cculpepper/SpexPressureSensor/SpexPressureSensor.kicad_pcb

## KiCad design SpexPressureSensor.kicad_pcb (2016-04-12)

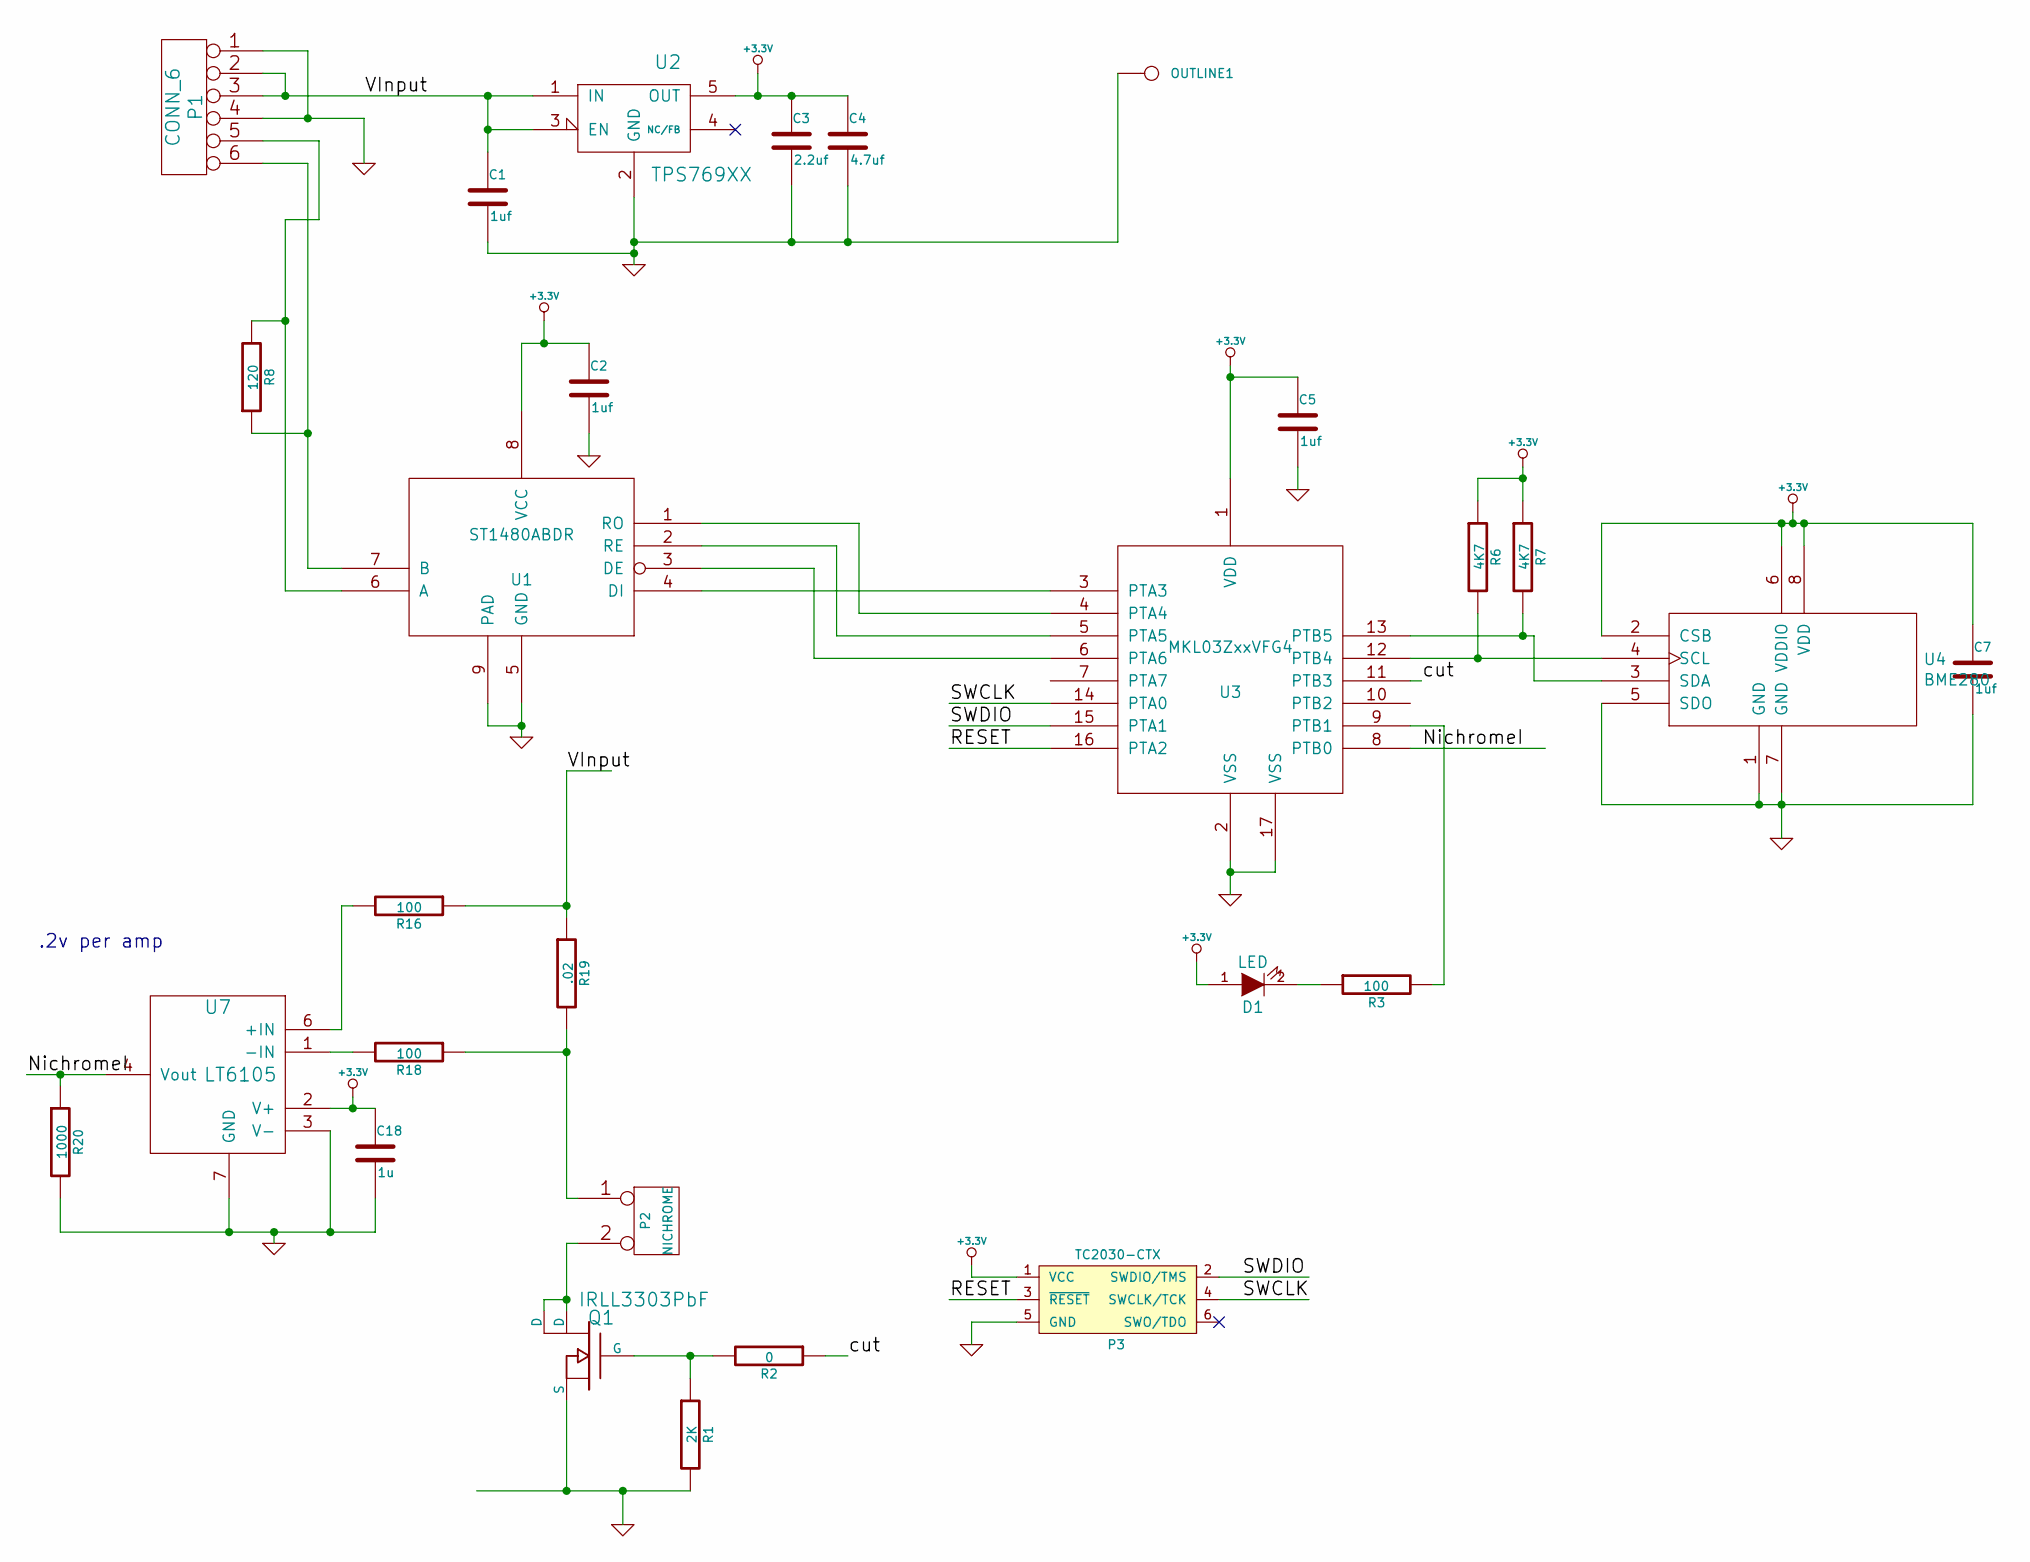
[picture p1: schematic SpexPressureSensor.sch]

Parts:
C1, C2, C5, C7: 1uf; C_0402
C3: 2.2uf; C_0603
C4: 4.7uf; C_0603
C18: 1u; C_0402
D1: LED; LED-0603
OUTLINE1: CONN_1; PLUG_OUTLINE
P1: CONN_6; Connector_Molex_PicoBlade_53047-0610
P2: NICHROME; Pin_Header_Straight_1x02
P3: TC2030-CTX; TC2030-NL_SMALL
Q1: IRLL3303PbF; SOT-223
R1: 2K; R_0402
R2: 0; R_0402
R3, R16, R18: 100; R_0402
R6, R7: 4K7; R_0402
R8: 120; R_0402
R19: .02; R_0805
R20: 1000; R_0402
U1: ST1480ABDR; DFN-8-1EP_3x3mm_Pitch0.5mm; Manufacturer PN LTC2851IDD
U2: TPS769XX; SOT-23-5; Manufacturer PN NCP500SN33T1G
U3: MKL03ZxxVFG4; QFN-16-1EP_3x3mm_Pitch0.5mm
U4: BME280; LGA-8
U7: LT6105

Connections:
+3.3V: C2.1, C3.1, C4.1, C5.1, C7.1, C18.1, D1.1 (A), P3.1 (VCC), R6.1, R7.1, U1.8 (VCC), U2.5 (OUT), U3.1 (VDD), U4.2 (CSB), U4.6 (VDDIO), U4.8 (VDD), U7.2 (V+)
/NichromeI: R20.1, U3.8 (PTB0), U7.4 (Vout)
/RESET: P3.3 (~RESET~), U3.16 (PTA2)
/SWCLK: P3.4 (SWCLK/TCK), U3.14 (PTA0)
/SWDIO: P3.2 (SWDIO/TMS), U3.15 (PTA1)
/VInput: C1.1, P1.2, P1.3, R16.1, R19.1, U2.1 (IN), U2.3 (EN)
/cut: R2.1, U3.11 (PTB3)
GND: C1.2, C2.2, C3.2, C4.2, C5.2, C7.2, C18.2, OUTLINE1.1, P1.1, P1.4, P3.5 (GND), Q1.3 (S), R1.2, R20.2, U1.5 (GND), U1.9 (PAD), U2.2 (GND), U3.2 (VSS), U3.17 (VSS), U4.1 (GND), U4.5 (SDO), U4.7 (GND), U7.3 (V-), U7.7 (GND)
unnamed: D1.2 (K), R3.1
unnamed: P1.5, R8.2, U1.6 (A)
unnamed: P1.6, R8.1, U1.7 (B)
unnamed: P2.1, R18.1, R19.2
unnamed: P2.2 (PM), Q1.2 (D), Q1.4 (D)
unnamed: Q1.1 (G), R1.1, R2.2
unnamed: R3.2, U3.9 (PTB1)
unnamed: R6.2, U3.12 (PTB4), U4.4 (SCL)
unnamed: R7.2, U3.13 (PTB5), U4.3 (SDA)
unnamed: R16.2, U7.6 (+IN)
unnamed: R18.2, U7.1 (-IN)
unnamed: U1.1 (RO), U3.4 (PTA4)
unnamed: U1.2 (RE), U3.5 (PTA5)
unnamed: U1.3 (DE), U3.6 (PTA6)
unnamed: U1.4 (DI), U3.3 (PTA3)

Notes on the sheet:
.2v per amp

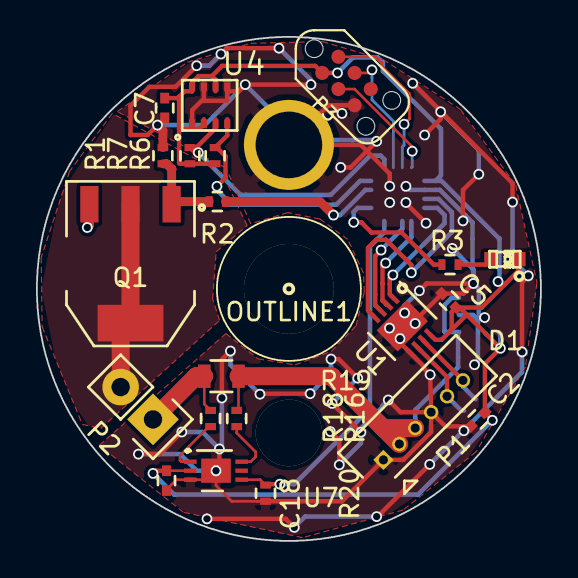
[picture p2: board SpexPressureSensor.kicad_pcb from above]

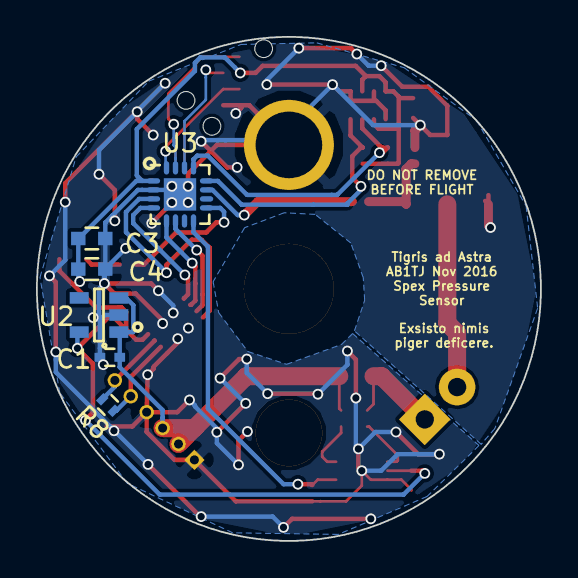
[picture p3: board SpexPressureSensor.kicad_pcb from below]

Board: 2 copper layers, 28.0 x 28.0 mm, 28 parts (6 on the bottom side), 23 nets.
