cculpepper/SpexPressureSensor/(commit log)

2015-11-18 Initial commit of the SpexPressureSensor hardware
    Has an accelerometer, barometer and thermometer
    Control is a KL03
    Has a big MOSFET to turn on nichrome wire
    Communicates using RS485.
    [SpexPressureSensor.kicad_pcb, SpexPressureSensor.sch, file5648EBFD.sch]
2015-11-18 Made the hole for the wires an actual hole...
    Probably need to make it bigger.
    [SpexPressureSensor.kicad_pcb]
2015-11-18 Moved some traces around.
    [SpexPressureSensor.kicad_pcb]
2015-11-19 Added a current monitor on the nichrome.
    [SpexPressureSensor.kicad_pcb, SpexPressureSensor.sch, _order_pcb.csv, bom_pcb.csv, file5648EBFD.sch]
2015-11-20 Realized the board was tooooo big.
    [SpexPressureSensor.kicad_pcb, SpexPressureSensor.sch]
2016-02-18 Finished board. Ready to go. Should add gerbers.
    [SpexPressureSensor.kicad_pcb, SpexPressureSensor.sch, _order_pcb.csv, bom_pcb.csv, file5648EBFD.sch]
2016-02-18 Added a bom and gerbers.
    [SpexPressureSensor-B.Cu.gbl, SpexPressureSensor-B.Fab.gbr, SpexPressureSensor-B.Mask.gbs, SpexPressureSensor-B.SilkS.gbo, SpexPressureSensor-Edge.Cuts.gm1, SpexPressureSensor-F.Cu.gtl, SpexPressureSensor-F.Fab.gbr, SpexPressureSensor-F.Mask.gts]
2016-04-11 Changed the bmp180 for teh bme
    [SpexPressureSensor-B.Cu.gbl, SpexPressureSensor-B.Fab.gbr, SpexPressureSensor-B.Mask.gbs, SpexPressureSensor-B.SilkS.gbo, SpexPressureSensor-Edge.Cuts.gm1, SpexPressureSensor-F.Cu.gtl, SpexPressureSensor-F.Fab.gbr, SpexPressureSensor-F.Mask.gts]
2016-04-11 Commiting the rest of teh files
    [SpexPressureSensor.kicad_pcb, SpexPressureSensor.sch, _order_pcb.csv, _saved_SpexPressureSensor.sch, bom.csv, bom_pcb.csv]
2016-04-12 Fixed some issues
    [SpexPressureSensor-B.Cu.gbl, SpexPressureSensor-B.Fab.gbr, SpexPressureSensor-B.Mask.gbs, SpexPressureSensor-B.SilkS.gbo, SpexPressureSensor-Edge.Cuts.gm1, SpexPressureSensor-F.Cu.gtl, SpexPressureSensor-F.Fab.gbr, SpexPressureSensor-F.Mask.gts]
